HugoBruins/cancatchers/results launch date/data + plotting code/map.png

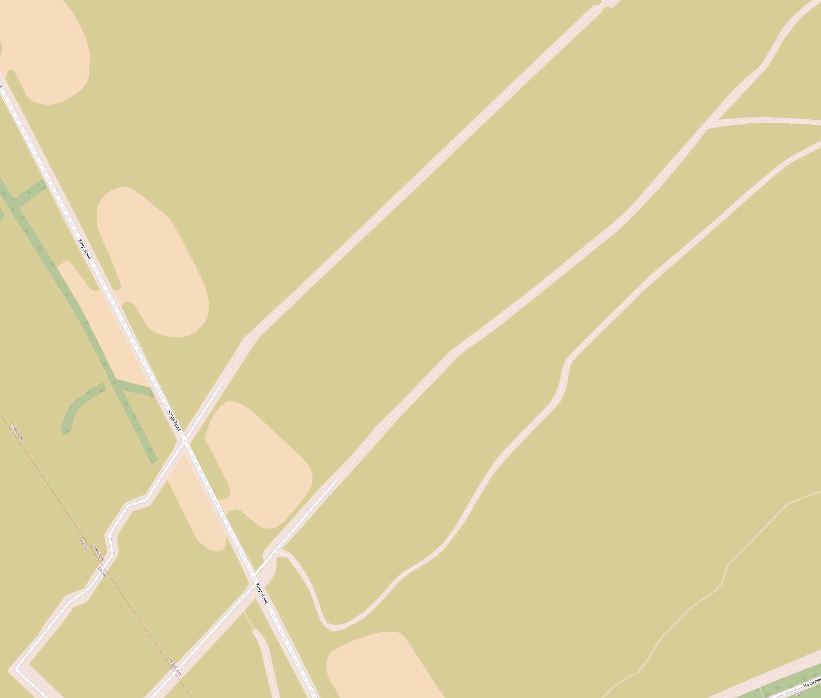
results launch date/data + plotting code/map.png
