HugoBruins/cancatchers/(commit log)

2020-12-09 Update temperatuur_en_druk_verzenden.ino
    extra comments over bedrading toegevoegd
2021-03-16 Update Better_happy_code.ino
    Rare nulmeting op batterijenergie, dus ik heb een opwarmfunctie voor de bmp280 toegevoegd
2021-03-18 It actually has an interrupt
2021-03-31 Added code for heatmapping the highest points on 2d map
2021-03-31 Heatmap example
2021-06-11 Added all the extra code for temperature reading
    new issue: Fat16 doesn't work, so we have to minimize dynamic memory to use SDfat
2021-06-11 Update and rename arduino/FinalBoss/final_cansat_code_gps.ino to arduino/cansat_code/cansat_code_gps.ino
2021-06-11 Update and rename arduino/FinalBoss/final_cansat_code_gps_bmp.ino to arduino/cansat_code/cansat_code_gps_bmp.ino
2021-06-11 Update and rename arduino/FinalBoss/final_cansat_code_all.ino to arduino/cansat_code/cansat_code_all.ino
2021-06-12 code was updated to the wrong place yesterday
    [cansat_code_gps_bmp.ino]
2021-06-17 It now plots barebones temperature, altitude and pressure data
2021-06-17 It now plots altitude, pressure and temperature afterward
2021-06-24 Rename groundstation_all_fallback.ino to (WIP) groundstation_all_fallback.ino
2021-06-28 63% dynamic memory was actualy 60% :)
    Correcting
    [cansat_code_all.ino]
2021-06-28 Reordered the functions to be at the top
    Also removed the currently unsupported wind speed plotting for this code, haven't got my hands on the CanSat with the working GPS module to implement this.
2021-06-28 Renamed to pain (click for explanation).
    I wanted to keep this in so everyone can look at the struggles of getting 2 software serial devices to work together while also having problems with the APC220 module not going beyond 1 Hz, basically, a giant rabbit hole of interrupt transmitting and once in a while losing the send data because of interrupting the GPS loop. (While also minimizing dynamic memory, because the SD card was also unstable, in hindsight I could have done a bit more optimization though)
    At least this code worked so we will keep it as a trophy I guess. I used some of it as a reference for writing the new code, I almost wanted to delete but I was like no, I learned too much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
    [pain.ino]
